pacabot/nara-kicad/FAB/BOM/NARA_v1.0.0-B1.ods

Gerber Version |  | NARA V1.1.0 B2
PCB Class (Eurocircuit dimension en µm)
Epaisseur (mm) |  | 1.6
Piste & Isol. Min. (µm) |  | 125/125
Colerette via (µm) |  | 125
Densité des trous (dm²) |  | <1500
Class |  | 6C
Vernis Epargne |  | 2 faces
Dim. Unitaire (mm) |  | 94.00 x 42.50
Impédance Controlée |  | Non
STACKUP (EuroCircuits dimension en µm)
MC4 1.55 | 1 | Foil – SIGNAL |  |  | 18
 |  | Prepeg (18+18) |  |  | 360
 |  | prepeg
 | 2 | Cuivre int – POWER | 18 |  | 35
 |  | Core FR4 |  |  | 710
 | 3 | Cuivre int – GND | 18 |  | 35
 |  | Prepeg (18+18) |  |  | 360
 |  | 0,20 mm (1 x 2116 1 x 1080) | 200
 | 4 | Foil – SIGNAL | 18 |  | 18
 |  |  |  |  | 1540
id | Component |  |  | sIdUpper |  | Case | Manufacturer | Reference man | quantity | datasheet
1 | C1 | C1 | C1 | C_0038 |  | C_1206 | 50V | 4.7uF | 1 | generic
2 | C11 C24 C28 C31 C34 C35 C36 C43 C44 | C11 C24 C28 C31 C34 C35 C36 C43 C44 | C11 C24 C28 C31 C34 C35 C36 C43 C44 | C_0002 |  | C_0402 | 25V | 100nF | 9 | generic
3 | C12 C13 | C12 C13 | C12 C13 | C_0034 |  | C_0402 | 50V | 10nF | 2 | generic
4 | C14 C30 C33 C42 | C14 C30 C33 C42 | C14 C30 C33 C42 | C_0045 |  | C_0402 | 25V | 2.2uF | 4 | generic
5 | C18 C19 | C18 C19 | C18 C19 | C_220nF |  | C_0603 | 50V | 220nF | 2 | generic
6 | C2 C25 C41 | C2 C25 C41 | C2 C25 C41 | C_0001 |  | C_0402 | 25V | 10nF | 3 | generic
7 | C22 C23 | C22 C23 | C22 C23 | C_0040 |  | C_1210 | 10V | 47uF | 2 | generic
8 | C29 | C29 | C29 | C_0007 |  | C_1206 | 25V | 4.7uF | 1 | generic
9 | C15 C16 C17 C3 | C15 C16 C17 C3 | C15 C16 C17 C3 | C_0056 |  | C_0805 | 50V | 1uF | 4 | generic
10 | C4 C5 C7 C8 | C4 C5 C7 C8 | C4 C5 C7 C8 | C_47uF |  | CP_EIA-7343-31 | 35V | 47uF | 4 | generic
11 | C45 | C45 | C45 | C_470nF |  | C_0402 | 25V | 470nF | 1 | generic
12 | C26 C37 C38 C39 C40 C6 | C26 C37 C38 C39 C40 C6 | C26 C37 C38 C39 C40 C6 | C_0037 |  | C_0603 | 25V | 1uF | 6 | generic
13 | C10 C21 C9 | C10 C21 C9 | C10 C21 C9 | C_0033 |  | C_0603 | 50V | 100nF | 3 | generic
14 | D1 D2 D3 D4 | D1 D2 D3 D4 | D1 D2 D3 D4 | D_0022 |  | D_SOD-523 | On Semiconductor | 1N4148WT | 4 | http://www.farnell.com/datasheets/2287915.pdf
15 | D5 D6 D11 | D11 D5 | D11 D5 | D_0001 |  | LED_0603-red | VISHAY | TLMS1000-GS08 | 3 | http://www.vishay.com/docs/83172/tlmo1000.pdf
16 | F1 | F1 | F1 | FUSE |  | F_1206 |  |  | 1 | http://www.farnell.com/datasheets/2571626.pdf
17 | K1 | K1 | K1 | BATT |  | Pin_Header_Straight_1x02_Pitch3mm |  |  | 1 | n.c
18 | K9 K10 K11 K12 K13 K14 | K10 | K10 | TOF |  | GYVL53L0X |  |  | 6 | n.c
19 | K2 | K2 | K2 | K_FPC_52435-2471 |  | K_FPC_52435-2471 |  |  | 1 | https://www.molex.com/molex/products/datasheet.jsp?part=active/0524352471_FFC_FPC_CONNECTORS.xml
20 | K3 | K3 | K3 | PROG |  | FTSH-105-XX-X-DV | SAMTEC | FTSH-105-01-F-DV-K | 1
21 | K5 K7 | K5 K7 | K5 K7 | K_PicoSPOX-3 |  | K_PicoSPOX-3 | MOLEX |  | 2 | http://www.molex.com/pdm_docs/sd/874380543_sd.pdf
22 | K6 K8 | K6 K8 | K6 K8 | K_0002 |  | K_PicoSPOX-5 | MOLEX |  | 2 | n.c
23 | L1 | L1 | L1 | L_0002 |  | L_5030-Coilcraft | Coilcraft | XAL5030-222MEC | 1 | http://www.farnell.com/datasheets/1681990.pdf
24 | L2 | L2 | L2 | L_0010 |  | L_0603 | TDK | MMZ1608B121C | 1 | http://www.farnell.com/datasheets/84899.pdf
25 | Q2 Q3 Q4 Q5 Q6 Q7 | Q2 Q3 Q4 Q5 Q6 Q7 | Q2 Q3 Q4 Q5 Q6 Q7 | Q_0007 |  | SOT_23 | SOT_23 | BSS84 | 6 | http://www.farnell.com/datasheets/301708.pdf
26 | Q1 Q8 Q9 | Q1 Q8 Q9 | Q1 Q8 Q9 | Q_0004 |  | SOT_23 | NXP | BSS138BK | 3 | https://assets.nexperia.com/documents/data-sheet/BSS138BK.pdf
27 | R11 R14 R62 R63 R64 R65 R66 R67 R7 | R11 R14 R62 R63 R64 R65 R66 R67 R7 | R11 R14 R62 R63 R64 R65 R66 R67 R7 | R_0111 |  | R_0402 | 1% | 2K | 9 | generic
28 | R17 | R17 | R17 | R_0030 |  | R_0402 | 1% | 18.2K | 1 | generic
29 | R18 | R18 | R18 | R_0088 |  | R_1206 | 1% | 0.015 | 1 | generic
30 | R23 | R23 | R23 | R_0118 |  | R_0402 | 1% | 1.5K | 1 | generic
31 | R31 R32 R33 R34 R35 R36 | R31 R32 R33 R34 R35 R36 | R31 R32 R33 R34 R35 R36 | R_0015 |  | R_0402 | 1% | 4.7K | 6 | generic
32 | R38 | R38 | R38 | R_0076 |  | R_0603 | 1% |  | 1 | generic
33 | R1 R10 R12 R13 R15 R16 R2 R3 R37 R39 R4 R40 R41 R42 R43 R44 R45 R46 R5 R6 R8 R9 | R1 R10 R12 R13 R15 R16 R2 R3 R37 R39 R4 R40 R41 R42 R43 R44 R45 R46 R5 R6 R8 R9 | R1 R10 R12 R13 R15 R16 R2 R3 R37 R39 R4 R40 R41 R42 R43 R44 R45 R46 R5 R6 R8 R9 | R_0002 |  | R_0402 | 1% | 1M | 22 | generic
34 | R47 R48 R49 R50 | R47 R48 R49 R50 | R47 R48 R49 R50 | R_0033 |  | R_0402 | 1% |  | 4 | generic
35 | R29 R30 R53 R54 R55 R56 | R29 R30 R53 R54 R55 R56 | R29 R30 R53 R54 R55 R56 | R_0105 |  | R_0402 | 1% | 47K | 6 | generic
36 | R19 R57 | R57 | R57 | R_0104 |  | R_0402 | 1% |  | 2 | generic
37 | SP1 | SP1 | SP1 | SP_0001 |  | SP_KSSG-5x5x3 | BUZZER | KSSG13J12 | 1 | http://www.farnell.com/datasheets/1653456.pdf?_ga=2.105053891.1391353022.1498466693
38 | SW1 SW2 | SW1 SW2 | SW1 SW2 | SW_SKQG |  | SPST_SKQG |  |  | 2 | http://www.alps.com/prod/info/E/HTML/Tact/SurfaceMount/SKQG/SKQG_list.html
39 | U1 | U1 | U1 | U_LT8610ABIMSE-3.3 |  | MSOP_16-1EP_3x4_P0.5 | Linear Technology | LT8610ABIMSE-3.3 | 1 | http://cds.linear.com/docs/en/datasheet/8610abfa.pdf
40 | U2 | U2 | U2 | U_AP2204K-5.0TRG1 |  | SOT_23-5 | Diodes INC | TPS70950DBVT | 1 | https://www.diodes.com/assets/Datasheets/AP2204.pdf
41 | U3 | U3 | U3 | LTC2944 |  | DFN_8-1EP_3x3mm_P0.5mm | Linear Technology | LTC2944 | 1 | http://www.analog.com/media/en/technical-documentation/data-sheets/2944fa.pdf
42 | U4 U5 | U4 U5 | U4 U5 | L6234 |  | PowerSO-20 |  | L6234 | 2 | http://www.st.com/resource/en/datasheet/l6234.pdf
43 | U6 | U6 | U6 | LTC2955TS8-1 |  | SOT_23-8 |  | LTC2955TS8-1 | 1
44 | U7 | U7 | U7 | STM32H743VITx |  | LQFP-100_14x14mm_Pitch0.5mm |  | STM32H743VITx | 1 | http://www.st.com/resource/en/datasheet/stm32h743bi.pdf
45 | U8 | U8 | U8 | ICM-20689 |  | QFN-24-1EP_4x4mm_Pitch0.5mm |  | ICM-20689 | 1 | http://www.invensense.com/wp-content/uploads/2017/08/ICM-20689-v2.2-002.pdf
46 | U10 U11 U12 U9 | U10 U11 U12 U9 | U10 U11 U12 U9 | QRE1113GR |  | QRE1113GR |  | QRE1113GR | 4 | https://www.pololu.com/file/0J117/QRE1113GR.pdf
 |  |  |  |  |  |  |  |  | 142
