pacabot/nara-kicad/Freecad/NARA_EdgeCuts.dxf

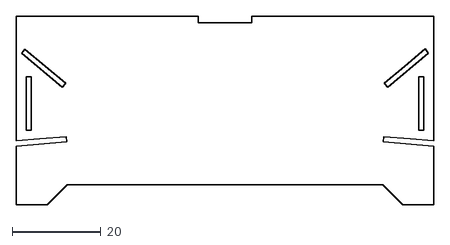
[picture p1: CAD file, 2018-04-18]
Freecad/NARA_EdgeCuts.dxf
93.9 x 42.4
