pacabot/nara-kicad/(list of files, cad)

Other CAD files:
Freecad/EdgeCuts.fcstd
