pacabot/nara-kicad/NARA.kicad_pcb

## KiCad design NARA.kicad_pcb (2018-04-25)

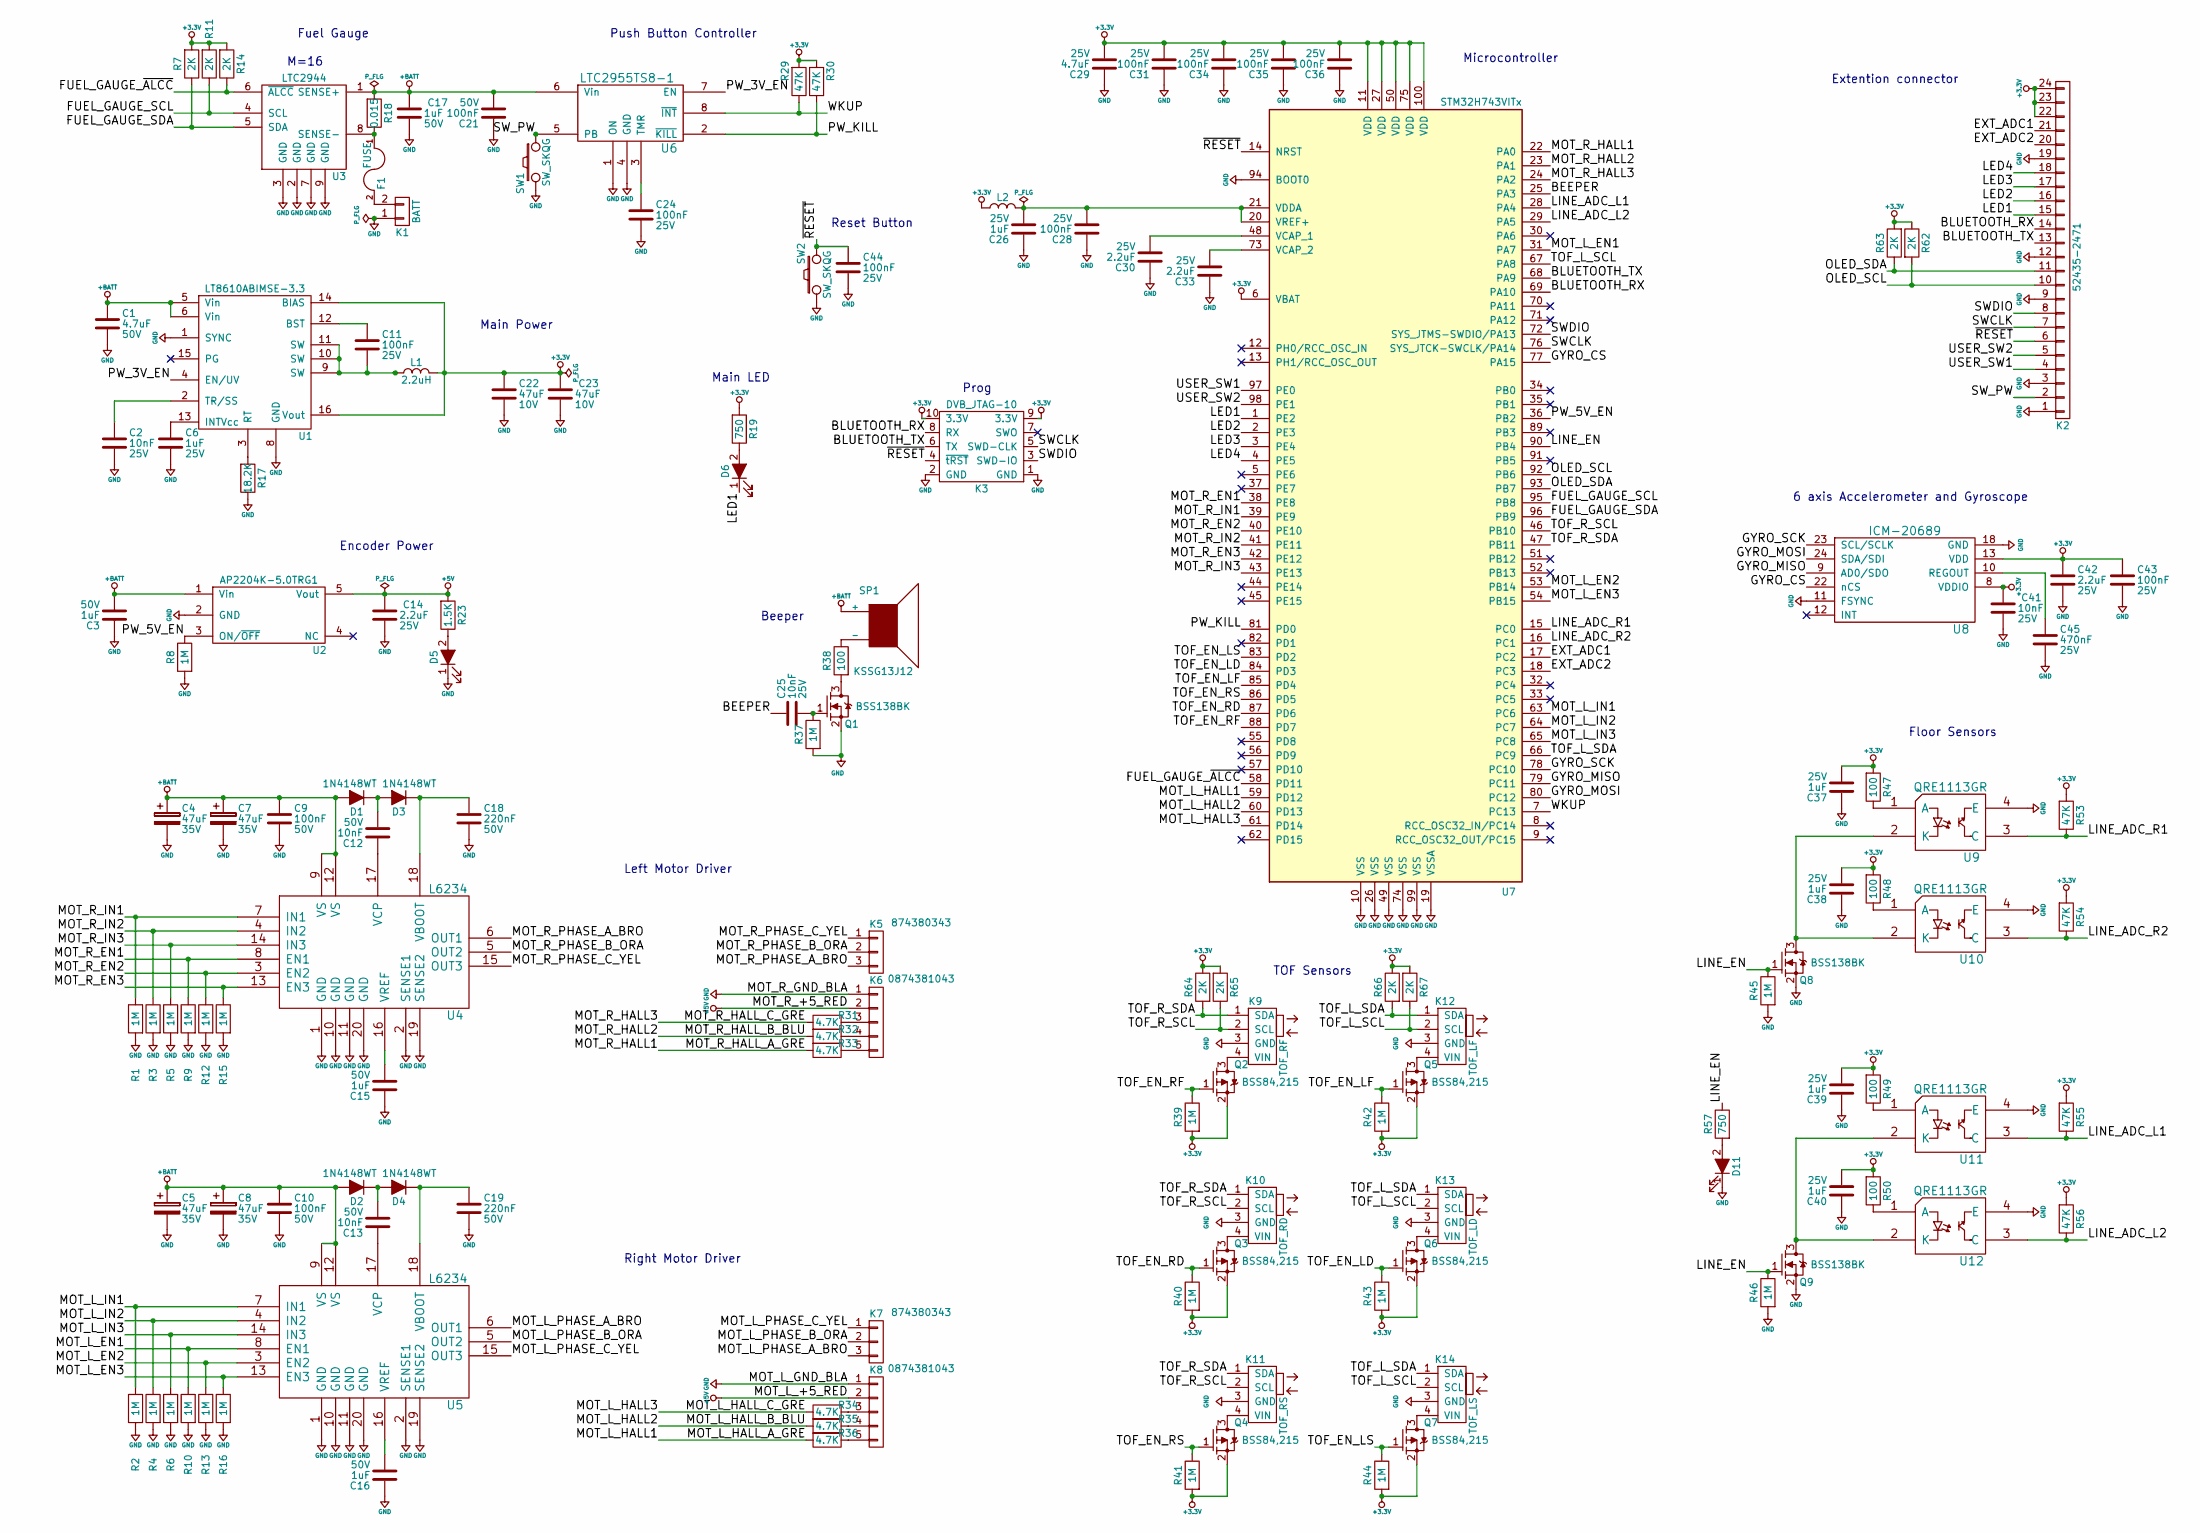
[picture p2: schematic NARA.sch]

Parts:
C1: C_0038; C_1206
C2, C25, C41: C_0001; C_0402
C3, C15, C16, C17: C_0056; C_0805
C4, C5, C7, C8: C_47uF; CP_EIA-7343-31
C6, C26, C37, C38, C39, C40: C_0037; C_0603
C9, C10, C21: C_0033; C_0603
C11, C24, C28, C31, C34, C35, C36, C43, C44: C_0002; C_0402
C12, C13: C_0034; C_0402
C14, C30, C33, C42: C_0045; C_0402
C18, C19: C_220nF; C_0603
C22, C23: C_0040; C_1210
C29: C_0007; C_1206
C45: C_470nF; C_0402
D1, D2, D3, D4: D_0022; D_SOD-523
D5, D6, D11: D_0001; LED_0603-red
F1: FUSE; F_1206
K1: BATT; Pin_Header_Straight_1x02_Pitch3mm
K2: K_FPC_52435-2471
K3: DVB_JTAG-10; FTSH-105-XX-X-DV
K5, K7: K_PicoSPOX-3
K6, K8: K_0002; K_PicoSPOX-5
K9: TOF_RF; GYVL53L0X
K10: TOF_RD; GYVL53L0X
K11: TOF_RS; GYVL53L0X
K12: TOF_LF; GYVL53L0X
K13: TOF_LD; GYVL53L0X
K14: TOF_LS; GYVL53L0X
L1: L_0002; L_5030-Coilcraft
L2: L_0010; L_0603
Q1, Q8, Q9: Q_0004; SOT_23
Q2, Q3, Q4, Q5, Q6, Q7: Q_0007; SOT_23
R1, R2, R3, R4, R5, R6, R8, R9, R10, R12, R13, R15, R16, R37, R39, R40, R41, R42, R43, R44, R45, R46: R_0002; R_0402
R7, R11, R14, R62, R63, R64, R65, R66, R67: R_0111; R_0402
R17: R_0030; R_0402
R18: R_0088; R_1206
R19, R57: R_0104; R_0402
R23: R_0118; R_0402
R29, R30, R53, R54, R55, R56: R_0105; R_0402
R31, R32, R33, R34, R35, R36: R_0015; R_0402
R38: R_0076; R_0603
R47, R48, R49, R50: R_0033; R_0402
SP1: SP_0001; SP_KSSG-5x5x3
SW1, SW2: SW_SKQG; SPST_SKQG
U1: U_LT8610ABIMSE-3.3; MSOP_16-1EP_3x4_P0.5
U2: U_AP2204K-5.0TRG1; SOT_23-5
U3: LTC2944; DFN_8-1EP_3x3mm_P0.5mm
U4, U5: L6234; PowerSO-20
U6: LTC2955TS8-1; SOT_23-8
U7: STM32H743VITx; LQFP-100_14x14mm_Pitch0.5mm
U8: ICM-20689; QFN-24-1EP_4x4mm_Pitch0.5mm
U9, U10, U11, U12: QRE1113GR

Connections:
+3.3V: C22.1, C23.1, C29.2, C31.2, C34.2, C35.2, C36.2, C37.2, C38.2, C39.2, C40.2, C41.1, C42.1, C43.1, K2.22, K2.23, K2.24, K3.9 (3.3V), K3.10 (3.3V), L1.2, L2.1, Q2.2 (S), Q3.2 (S), Q4.2 (S), Q5.2 (S), Q6.2 (S), Q7.2 (S), R7.1, R11.1, R14.1, R19.1, R29.1, R30.1, R39.1, R40.1, R41.1, R42.1, R43.1, R44.1, R47.1, R48.1, R49.1, R50.1, R53.1, R54.1, R55.1, R56.1, R62.2, R63.1, R64.2, R65.1, R66.2, R67.1, U1.14 (BIAS), U1.16 (Vout), U7.6 (VBAT), U7.11 (VDD), U7.27 (VDD), U7.50 (VDD), U7.75 (VDD), U7.100 (VDD), U8.8 (VDDIO), U8.13 (VDD)
+5V: C14.1, K6.2, K8.2, R23.1, U2.5 (Vout)
+BATT: C1.1, C3.2, C4.1, C5.1, C7.1, C8.1, C9.1, C10.1, C17.1, C21.2, D1.2 (A), D2.2 (A), R18.1, SP1.1 (+), U1.5 (Vin), U1.6 (Vin), U2.1 (Vin), U3.1 (SENSE+), U4.9 (VS), U4.12 (VS), U5.9 (VS), U5.12 (VS), U6.6 (Vin)
/BEEPER: C25.1, U7.25 (PA3)
/BLUETOOTH_RX: K2.14, K3.8 (RX), U7.69 (PA10)
/BLUETOOTH_TX: K2.13, K3.6 (TX), U7.68 (PA9)
/EXT_ADC1: K2.21, U7.17 (PC2)
/EXT_ADC2: K2.20, U7.18 (PC3)
/FUEL_GAUGE_SCL: R11.2, U3.4 (SCL), U7.95 (PB8)
/FUEL_GAUGE_SDA: R7.2, U3.5 (SDA), U7.96 (PB9)
/FUEL_GAUGE_~ALCC: R14.2, U3.6 (~ALCC), U7.58 (PD11)
/GYRO_CS: U7.77 (PA15), U8.22 (nCS)
/GYRO_MISO: U7.79 (PC11), U8.9 (AD0/SDO)
/GYRO_MOSI: U7.80 (PC12), U8.24 (SDA/SDI)
/GYRO_SCK: U7.78 (PC10), U8.23 (SCL/SCLK)
/LED1: D6.1 (K), K2.15, U7.1 (PE2)
/LED2: K2.16, U7.2 (PE3)
/LED3: K2.17, U7.3 (PE4)
/LED4: K2.18, U7.4 (PE5)
/LINE_ADC_L1: R55.2, U7.28 (PA4), U11.3 (C)
/LINE_ADC_L2: R56.2, U7.29 (PA5), U12.3 (C)
/LINE_ADC_R1: R53.2, U7.15 (PC0), U9.3 (C)
/LINE_ADC_R2: R54.2, U7.16 (PC1), U10.3 (C)
/LINE_EN: Q8.1 (G), Q9.1 (G), R45.2, R46.2, R57.2, U7.90 (PB4)
/MOT_L_EN1: R10.2, U5.8 (EN1), U7.31 (PA7)
/MOT_L_EN2: R13.2, U5.3 (EN2), U7.53 (PB14)
/MOT_L_EN3: R16.2, U5.13 (EN3), U7.54 (PB15)
/MOT_L_HALL1: R36.2, U7.59 (PD12)
/MOT_L_HALL2: R35.2, U7.60 (PD13)
/MOT_L_HALL3: R34.2, U7.61 (PD14)
/MOT_L_IN1: R2.2, U5.7 (IN1), U7.63 (PC6)
/MOT_L_IN2: R4.2, U5.4 (IN2), U7.64 (PC7)
/MOT_L_IN3: R6.2, U5.14 (IN3), U7.65 (PC8)
/MOT_L_PHASE_A_BRO: K7.3, U5.6 (OUT1)
/MOT_L_PHASE_B_ORA: K7.2, U5.5 (OUT2)
/MOT_L_PHASE_C_YEL: K7.1, U5.15 (OUT3)
/MOT_R_EN1: R9.2, U4.8 (EN1), U7.38 (PE8)
/MOT_R_EN2: R12.2, U4.3 (EN2), U7.40 (PE10)
/MOT_R_EN3: R15.2, U4.13 (EN3), U7.42 (PE12)
/MOT_R_HALL1: R33.2, U7.22 (PA0)
/MOT_R_HALL2: R32.2, U7.23 (PA1)
/MOT_R_HALL3: R31.2, U7.24 (PA2)
/MOT_R_IN1: R1.2, U4.7 (IN1), U7.39 (PE9)
/MOT_R_IN2: R3.2, U4.4 (IN2), U7.41 (PE11)
/MOT_R_IN3: R5.2, U4.14 (IN3), U7.43 (PE13)
/MOT_R_PHASE_A_BRO: K5.3, U4.6 (OUT1)
/MOT_R_PHASE_B_ORA: K5.2, U4.5 (OUT2)
/MOT_R_PHASE_C_YEL: K5.1, U4.15 (OUT3)
/OLED_SCL: K2.10, R62.1, U7.92 (PB6)
/OLED_SDA: K2.11, R63.2, U7.93 (PB7)
/PW_3V_EN: U1.4 (EN/UV), U6.7 (EN)
/PW_5V_EN: R8.2, U2.3 (ON/~OFF), U7.36 (PB2)
/PW_KILL: R30.2, U6.2 (~KILL), U7.81 (PD0)
/SWCLK: K2.7, K3.5 (SWD-CLK), U7.76 (SYS_JTCK-SWCLK/PA14)
/SWDIO: K2.8, K3.3 (SWD-IO), U7.72 (SYS_JTMS-SWDIO/PA13)
/SW_PW: K2.2, SW1.1, U6.5 (PB)
/TOF_EN_LD: Q6.1 (G), R43.2, U7.84 (PD3)
/TOF_EN_LF: Q5.1 (G), R42.2, U7.85 (PD4)
/TOF_EN_LS: Q7.1 (G), R44.2, U7.83 (PD2)
/TOF_EN_RD: Q3.1 (G), R40.2, U7.87 (PD6)
/TOF_EN_RF: Q2.1 (G), R39.2, U7.88 (PD7)
/TOF_EN_RS: Q4.1 (G), R41.2, U7.86 (PD5)
/TOF_L_SCL: K12.2 (SCL), K13.2 (SCL), K14.2 (SCL), R67.2, U7.67 (PA8)
/TOF_L_SDA: K12.1 (SDA), K13.1 (SDA), K14.1 (SDA), R66.1, U7.66 (PC9)
/TOF_R_SCL: K9.2 (SCL), K10.2 (SCL), K11.2 (SCL), R65.2, U7.46 (PB10)
/TOF_R_SDA: K9.1 (SDA), K10.1 (SDA), K11.1 (SDA), R64.1, U7.47 (PB11)
/USER_SW1: K2.4, U7.97 (PE0)
/USER_SW2: K2.5, U7.98 (PE1)
/WKUP: R29.2, U6.8 (~INT), U7.7 (PC13)
/~RESET: C44.1, K2.6, K3.4 (~tRST), SW2.2, U7.14 (NRST)
GND: C1.2, C2.2, C3.1, C4.2, C5.2, C6.2, C7.2, C8.2, C9.2, C10.2, C14.2, C15.1, C16.1, C17.2, C18.2, C19.2, C21.1, C22.2, C23.2, C24.2, C26.1, C28.1, C29.1, C30.1, C31.1, C33.1, C34.1, C35.1, C36.1, C37.1, C38.1, C39.1, C40.1, C41.2, C42.2, C43.2, C44.2, C45.2, D5.1 (K), D11.1 (K), K1.1, K2.1, K2.3, K2.9, K2.12, K2.19, K3.1 (GND), K3.2 (GND), K6.1, K8.1, K9.3 (GND), K10.3 (GND), K11.3 (GND), K12.3 (GND), K13.3 (GND), K14.3 (GND), Q1.2 (S), Q8.2 (S), Q9.2 (S), R1.1, R2.1, R3.1, R4.1, R5.1, R6.1, R8.1, R9.1, R10.1, R12.1, R13.1, R15.1, R16.1, R17.2, R37.1, R45.1, R46.1, SW1.2, SW2.1, U1.1 (SYNC), U1.8 (GND), U1.17 (GND), U2.2 (GND), U3.2 (GND), U3.3 (GND), U3.7 (GND), U3.9 (GND), U4.1 (GND), U4.2 (SENSE1), U4.10 (GND), U4.11 (GND), U4.19 (SENSE2), U4.20 (GND), U5.1 (GND), U5.2 (SENSE1), U5.10 (GND), U5.11 (GND), U5.19 (SENSE2), U5.20 (GND), U6.1 (ON), U6.4 (GND), U7.10 (VSS), U7.19 (VSSA), U7.26 (VSS), U7.49 (VSS), U7.74 (VSS), U7.94 (BOOT0), U7.99 (VSS), U8.11 (FSYNC), U8.18 (GND), U9.4 (E), U10.4 (E), U11.4 (E), U12.4 (E)
unnamed: C2.1, U1.2 (TR/SS)
unnamed: C6.1, U1.13 (INTVcc)
unnamed: C11.1, U1.12 (BST)
unnamed: C11.2, L1.1, U1.9 (SW), U1.10 (SW), U1.11 (SW)
unnamed: C12.1, U4.17 (VCP)
unnamed: C12.2, D1.1 (K), D3.2 (A)
unnamed: C13.1, U5.17 (VCP)
unnamed: C13.2, D2.1 (K), D4.2 (A)
unnamed: C15.2, U4.16 (VREF)
unnamed: C16.2, U5.16 (VREF)
unnamed: C18.1, D3.1 (K), U4.18 (VBOOT)
unnamed: C19.1, D4.1 (K), U5.18 (VBOOT)
unnamed: C24.1, U6.3 (TMR)
unnamed: C25.2, Q1.1 (G), R37.2
unnamed: C26.2, C28.2, L2.2, U7.20 (VREF+), U7.21 (VDDA)
unnamed: C30.2, U7.48 (VCAP_1)
unnamed: C33.2, U7.73 (VCAP_2)
unnamed: C45.1, U8.10 (REGOUT)
unnamed: D5.2 (A), R23.2
unnamed: D6.2 (A), R19.2
unnamed: D11.2 (A), R57.1
unnamed: F1.1, R18.2, U3.8 (SENSE-)
unnamed: F1.2, K1.2
unnamed: K6.3, R31.1
unnamed: K6.4, R32.1
unnamed: K6.5, R33.1
unnamed: K8.3, R34.1
unnamed: K8.4, R35.1
unnamed: K8.5, R36.1
unnamed: K9.4 (VIN), Q2.3 (D)
unnamed: K10.4 (VIN), Q3.3 (D)
unnamed: K11.4 (VIN), Q4.3 (D)
unnamed: K12.4 (VIN), Q5.3 (D)
unnamed: K13.4 (VIN), Q6.3 (D)
unnamed: K14.4 (VIN), Q7.3 (D)
unnamed: Q1.3 (D), R38.1
unnamed: Q8.3 (D), U9.2 (K), U10.2 (K)
unnamed: Q9.3 (D), U11.2 (K), U12.2 (K)
unnamed: R17.1, U1.3 (RT)
unnamed: R38.2, SP1.2 (-)
unnamed: R47.2, U9.1 (A)
unnamed: R48.2, U10.1 (A)
unnamed: R49.2, U11.1 (A)
unnamed: R50.2, U12.1 (A)

Notes on the sheet:
M=16
Microcontroller
Prog
Beeper
Left Motor Driver
Right Motor Driver
Main Power
Encoder Power
TOF Sensors
Floor Sensors
6 axis Accelerometer and Gyroscope
Reset Button
Fuel Gauge
Push Button Controller
Extention connector
Main LED

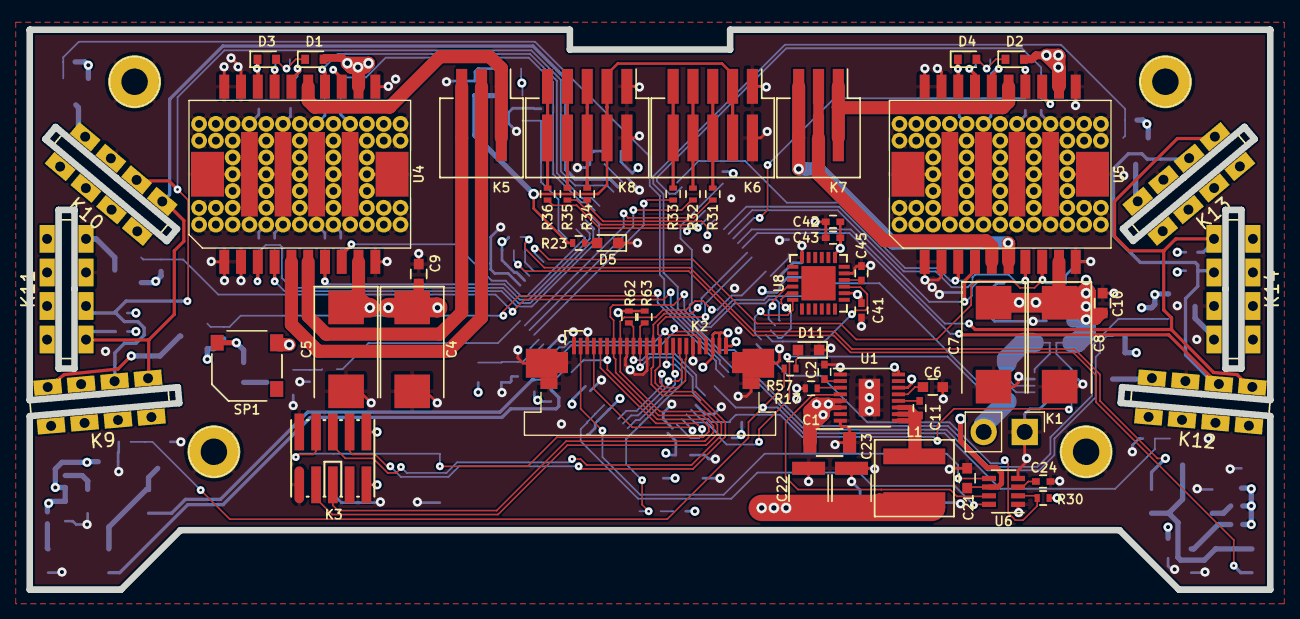
[picture p3: board NARA.kicad_pcb from above]

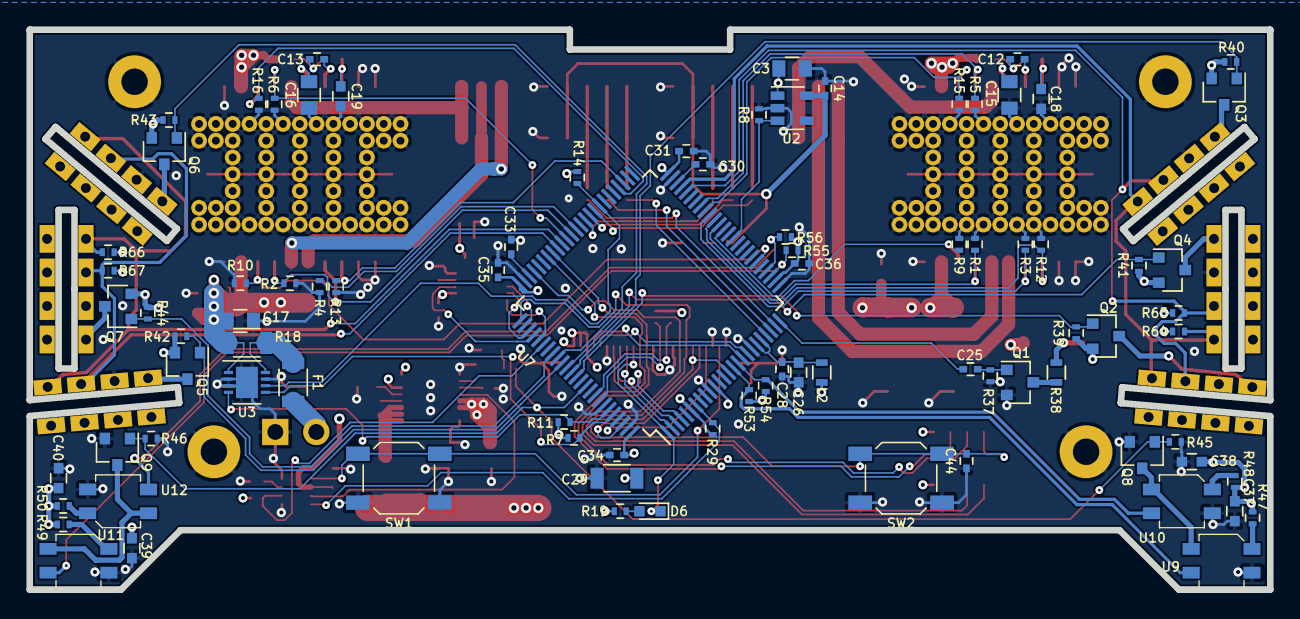
[picture p4: board NARA.kicad_pcb from below]

Board: 4 copper layers, 93.9 x 42.4 mm, 142 parts (86 on the bottom side), 115 nets.
