pacabot/nara-kicad/(commit log)

2018-04-07 First commit all files added
    [NARA.FCStd, NARA.kicad_pcb, NARA.sch, NARA1.step]
2018-04-07 split kicad and CubeMX project (move to eclipse project)
    [NARA.FCStd]
2018-04-07 Update schematic
    [NARA.sch]
2018-04-08 First schematic version
    [NARA.sch, NARA1.step]
2018-04-08 Update schematic create nara.lib
    [NARA.sch]
2018-04-08 Add NARA_Lib.pretty
    [NARA.sch]
2018-04-09 Update footprints, prepare to place composants
    [NARA.kicad_pcb, NARA.sch]
2018-04-15 First components placement, Autoroute in progress
    [NARA.kicad_pcb, NARA.sch]
2018-04-17 Add GND and PWR layer
    [NARA.kicad_pcb]
2018-04-18 Change EdgeCuts for TOF sensors, adapt power trace lengh
    [EdgeCuts.fcstd, NARA-Edge.Cuts.dxf, NARA.kicad_pcb, NARA.sch, NARA_EdgeCuts.dxf]
2018-04-19 Save before change vias
    [NARA.kicad_pcb]
2018-04-19 Update via type, route Top, GND, PWR complete
    [NARA.kicad_pcb]
2018-04-21 First NARA PCB, v1.0.0-B1
    [NARA.kicad_pcb, NARA.sch, NARA_v1.0.0-B1.ods]
2018-04-21 New v1.1.0, add jtag Connector and main led
    [NARA.kicad_pcb, NARA.sch]
2018-04-21 Generate gerbers, first eurocircuit purpose
    [NARA-Edge.Cuts.dxf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]
2018-04-22 Update Gerbers (clean errors for Eurocircuit)
    [NARA-B.Cu.gbr, NARA-B.Mask.gbr, NARA-B.Paste.gbr, NARA-Edge.Cuts.gbr, NARA-F.Cu.gbr, NARA-F.Mask.gbr, NARA-F.Paste.gbr, NARA-GND.Cu.gbr]
2018-04-23 Mouve debug connector
    [NARA-B.Cu.gbr, NARA-B.Mask.gbr, NARA-B.Paste.gbr, NARA-Edge.Cuts.gbr, NARA-F.Cu.gbr, NARA-F.Mask.gbr, NARA-F.Paste.gbr, NARA-GND.Cu.gbr]
2018-04-23 Change PCB sensors footprint
    [NARA-B.Cu.gbr, NARA-B.Mask.gbr, NARA-B.Paste.gbr, NARA-Edge.Cuts.gbr, NARA-F.Cu.gbr, NARA-F.Mask.gbr, NARA-F.Paste.gbr, NARA-GND.Cu.gbr]
2018-04-25 Eurocircuit v1.1.0-B1
    [NARA-B.Cu.gbr, NARA-B.Mask.gbr, NARA-B.Paste.gbr, NARA-Edge.Cuts.gbr, NARA-F.Cu.gbr, NARA-F.Mask.gbr, NARA-F.Paste.gbr, NARA-GND.Cu.gbr]
2018-04-25 Reduce TOF sensor footprint
    [NARA-B.Cu.gbr, NARA-B.Mask.gbr, NARA-B.Paste.gbr, NARA-Edge.Cuts.gbr, NARA-F.Cu.gbr, NARA-F.Mask.gbr, NARA-F.Paste.gbr, NARA-GND.Cu.gbr]
2018-04-25 In this version, we trust
    [NARA-B.Cu.gbr, NARA-B.Mask.gbr, NARA-B.Paste.gbr, NARA-Edge.Cuts.gbr, NARA-F.Cu.gbr, NARA-F.Mask.gbr, NARA-F.Paste.gbr, NARA-GND.Cu.gbr]
